josuebouchard/safe-dip-report/images/chapter-3/troubleshooting/damaged-leadscrew-holder/holder-repair-l-brackets.png

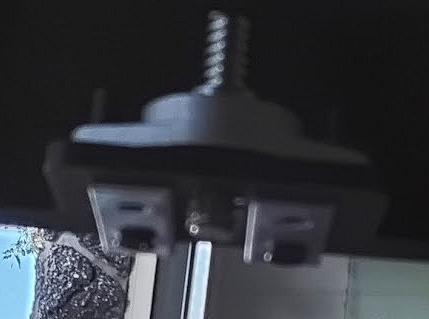
images/chapter-3/troubleshooting/damaged-leadscrew-holder/holder-repair-l-brackets.png
