josuebouchard/safe-dip-report/images/chapter-3/final-design/prototype-running-frame.png

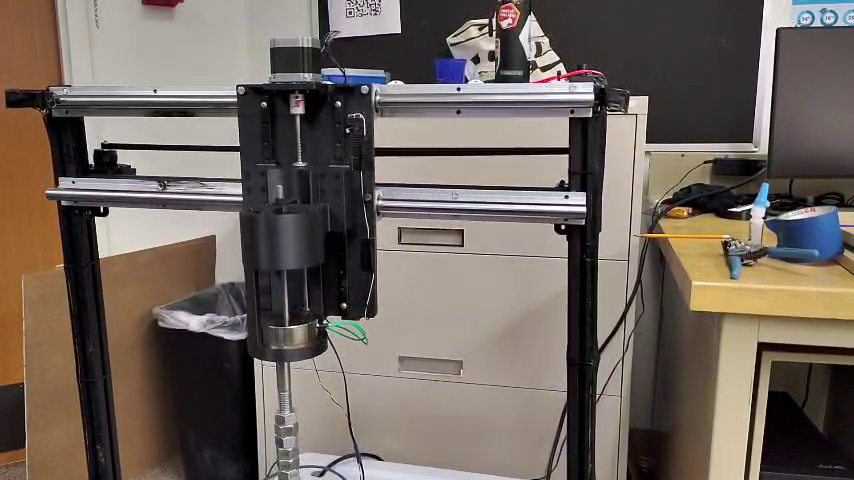
images/chapter-3/final-design/prototype-running-frame.png
