josuebouchard/safe-dip-report/images/chapter-3/implementation/communications-and-monitoring/dashboard-bottom.png

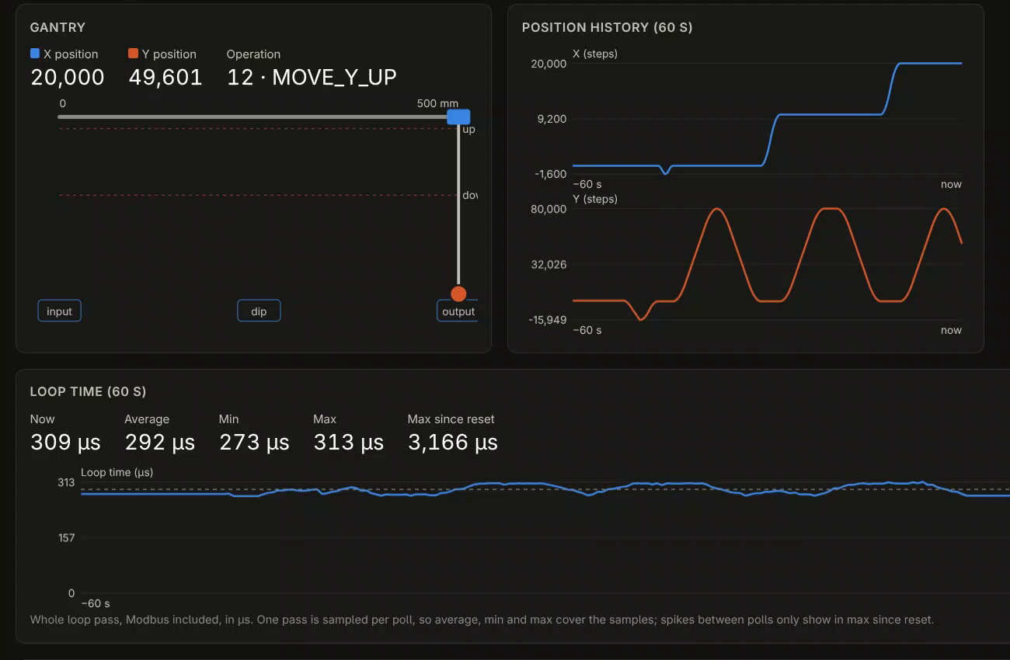
images/chapter-3/implementation/communications-and-monitoring/dashboard-bottom.png
