josuebouchard/safe-dip-report/images/chapter-3/implementation/communications-and-monitoring/dashboard-estop-latched.png

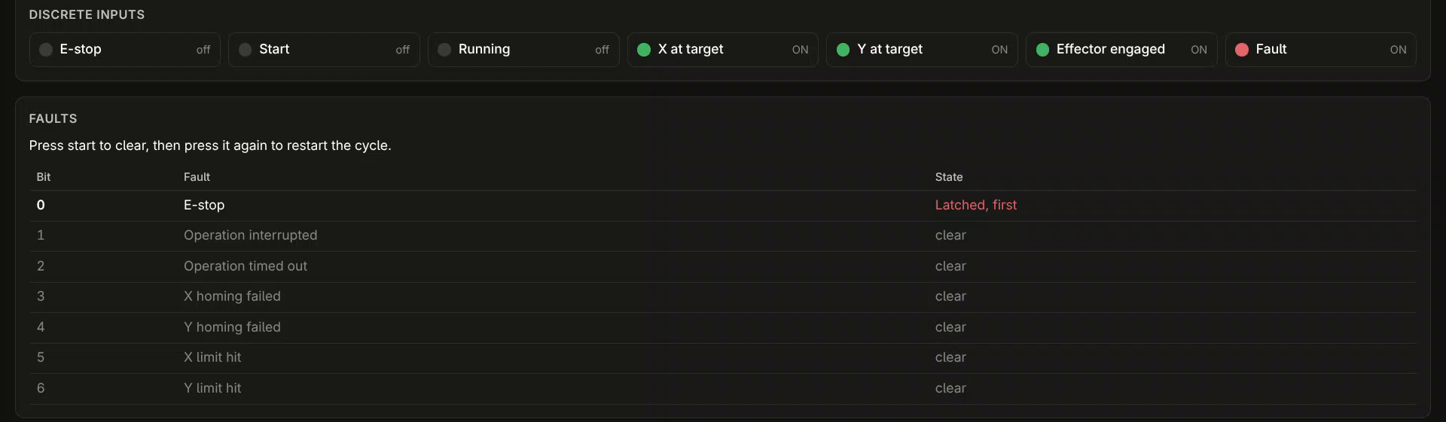
images/chapter-3/implementation/communications-and-monitoring/dashboard-estop-latched.png
