josuebouchard/safe-dip-report/images/chapter-3/implementation/communications-and-monitoring/dashboard-top.png

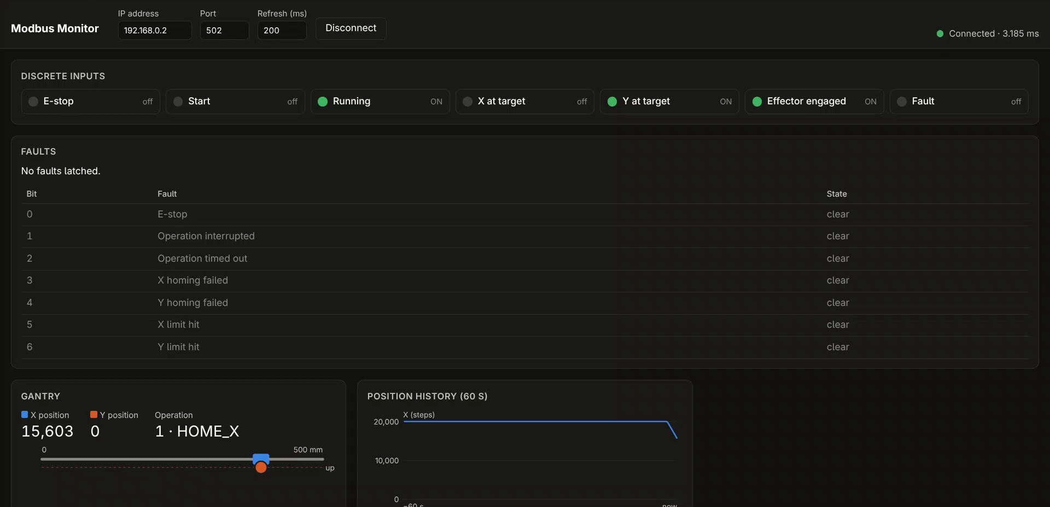
images/chapter-3/implementation/communications-and-monitoring/dashboard-top.png
