josuebouchard/safe-dip-report/images/chapter-3/implementation/sensing/limit-switches-in-video.png

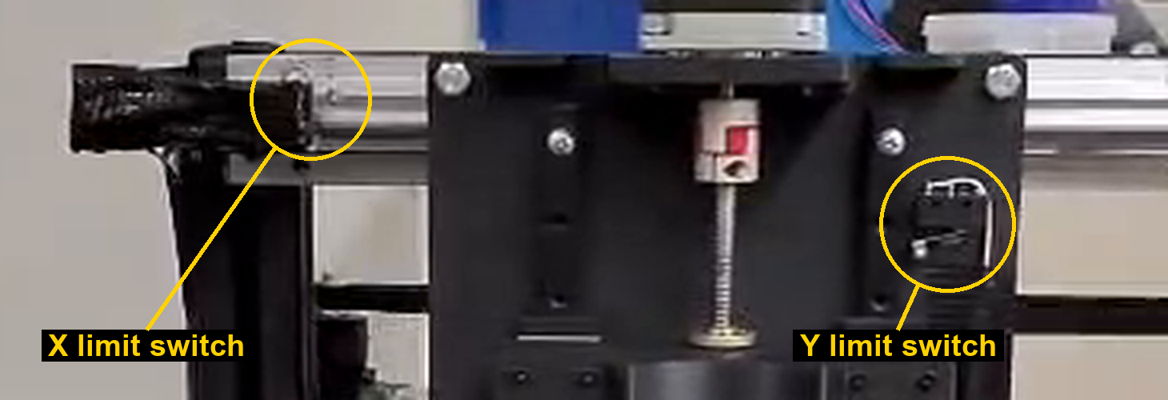
images/chapter-3/implementation/sensing/limit-switches-in-video.png
