josuebouchard/safe-dip-report/images/hardware/limit_switches.jpg

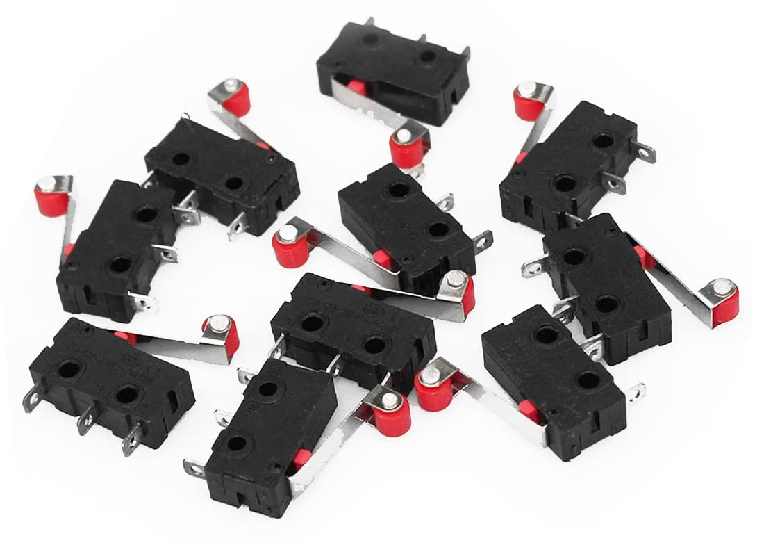
images/hardware/limit_switches.jpg
