josuebouchard/safe-dip-report/images/hardware/meanwell.webp

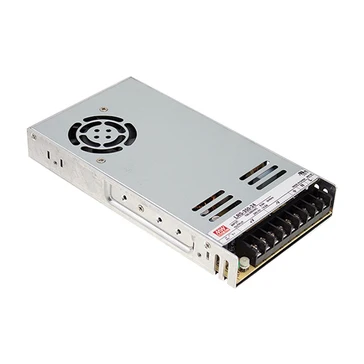
images/hardware/meanwell.webp
