josuebouchard/safe-dip-report/artifacts/EET4950_Weekly_Task_Plan_Safe_Dip.ods

EET 4950 – Weekly Task Plan · Safe Dip · Josué Bouchard, Adriano Mena Duque de Estrada · Fall 2026
Every Sunday, set Status (Done, Partial or Slipped) and fill Actual work and notes for the past week. Move slipped tasks to a later week and note it; do not delete the original row.
Owner = who leads the task; With = who helps. Both = a joint event.
Week | Week starting | Milestone | Task | Owner | With | Status | Actual work and notes
6 | Sep 28, 2026 |  | Rewrite report software section + 4 flowcharts | Josué |  | Done | Section and flowcharts match the firmware
6 | Sep 28, 2026 |  | Modbus map of cycle status and parameters | Josué |  | Partial | On a branch; not yet tested on the board
6 | Sep 28, 2026 |  | Fault reporting: latched e-stop, op. state | Josué |  | Partial | On a branch; bench test moved to Week 7
6 | Sep 28, 2026 |  | Limit-switch inputs and homing operation | Josué |  | Partial | On a branch; switches not yet mounted
6 | Sep 28, 2026 |  | Document power rails and open-drain wiring | Josué |  | Partial | In wiring.md; E5V supply
6 | Sep 28, 2026 |  | Website: flowcharts, nav fix, Week 5 log | Josué |  | Done | Posted on the team website
6 | Sep 28, 2026 |  | CAD: bearing block to plate connections | Adriano |  | Done
7 | Oct 5, 2026 |  | Fabricate mounting plate and 3D-printed carriage parts; mount bearing blocks on rails | Adriano |  | Done
7 | Oct 5, 2026 | Checkpoint 1 – Design Freeze due Sun Oct 11 | Freeze the X-carriage and Y-axis leadscrew CAD; release part drawings and cut list | Adriano |  | Partial | Major design for the X-carriage is done. Some tweaks are still needed to support the Y-axis leadscrew
7 | Oct 5, 2026 |  | Update block diagrams: 24 V supply, open-drain outputs (no buffer), limit switches, E5V | Josué |  | Slipped | Will be done next week
7 | Oct 5, 2026 |  | Draw KiCad schematic sheets for power, processing, movement, effector, e-stop and sensing | Josué |  | Partial | Still missing the part-detection sensor
7 | Oct 5, 2026 |  | Test Modbus registers on the board with madbus-cli | Josué |  | Done | Succesful test
7 | Oct 5, 2026 |  | Bench-test electromagnet driver: IRLZ44N at 3.3 V gate, flyback diode, coil current | Josué | Adriano | Partial | We found that the electromagnet takes about 1.5A of current at 12V DC. Only the magnet was tested; the MOSFET driver circuit moves to Week 9.
7 | Oct 5, 2026 |  | Write and submit Checkpoint 1 (Design Freeze) report | Josué | Adriano | Partial | A first version that better reassembles the structure provided by Dr. Socarras was created. However, things like budget, CAD modeling, and hardware are still to be updated.
7 | Oct 5, 2026 |  | Add the Weekly Task Plan to the website under the Project Timeline | Josué |  | Done | The weekly task plan was added under the project timeline
8 | Oct 12, 2026 |  | Install X-axis motor mount and GT2 belt drive on the frame | Adriano |  | Done | A support for the X-axis motor was successfully installed, as well as parts for coupling the stepper to the belt, holding the ball bearing that will serve as the other foci of the belt, and the contact point between the vertical assembly and the belt.
8 | Oct 12, 2026 |  | Mount X-axis limit switch; wire X driver, motor and switch to the Nucleo | Josué |  | Partial | Switches were defered to another week, since the primary focus will become the correct implementation of the movements before we add the limit switches and the position sensor.
8 | Oct 12, 2026 |  | Calibrate X-axis steps/mm; test homing and ±1 cm positioning (R-02) | Adriano | Josué | Partial | The operation "Homing" has not been tested since the limit switches have not been installed yet. However, the full process was tested with minimum steps skipped, easily attributable to small factors like bad crimping of belt (used clips to temporarily test it) and non-elliptical belt (requires to extrude the connecting part of the vertical assembly to get that).
8 | Oct 12, 2026 |  | Test Modbus communication in real-time with system working | Josué |  | Done | The system behaves correctly, but some disconnections were noticed. The reasons are still yet to be investigated further.
9 | Oct 19, 2026 | Checkpoint 2 – Mid-Build and Viability due Sun Oct 25 | Finish the Y-axis CAD tweaks; install the Y-axis leadscrew assembly, coupler and magnet holder | Adriano |  | Done
9 | Oct 19, 2026 |  | Wire the Y driver and motor to the Nucleo | Josué |  | Done | As it could be seen in previous videos, the stepper motor was succesfully integrated with the rest of the system
9 | Oct 19, 2026 |  | Build and bench-test the IRLZ44N magnet driver from PB10: drain-source voltage at 1.5 A, temperature, engage/release from firmware | Josué |  | Done | The IRLZ44N was substituted with a 5V relay module, providing better safety features than the MOSFET
9 | Oct 19, 2026 |  | Wire and test the 12 V supply: electromagnet rail and 12 V to 5 V buck converter | Josué |  | Partial | The electromagnet rail was successfully validated, but it couldn't be tested with the magnet, though it was tested with the multimeter. The 12V -> 5V buck converter was successfully connected, and voltage correctly adjusted.
9 | Oct 19, 2026 |  | Calibrate Y-axis steps/mm (2 mm lead: 800 steps/mm); test immersion depth ±1 cm (R-04) | Adriano | Josué | Slipped | We were unable to meet this week, so this will be displaced to next week.
9 | Oct 19, 2026 |  | Repeat the Y-axis down/up move 10 times; measure the drift at the top position | Adriano | Josué | Slipped | We were unable to meet this week, so this will be displaced to next week.
9 | Oct 19, 2026 |  | Replace the X-axis belt clips with a permanent belt clamp | Adriano |  | Partial | Waiting for another steeper
9 | Oct 19, 2026 |  | Decide and order the workpiece-detection sensor (time-of-flight, ultrasonic, or IR presence) | Josué | Adriano | Done | Based on the recommendations from the professor, an ultrasonic sensor was chosen because of affordability, abundance, simplicity and power, and, majorly, disponibility
9 | Oct 19, 2026 |  | Run first two-axis cycle without a part from the manual start position: pick, dip, deposit, release | Josué | Adriano | Slipped | The mechanical assembly and the electrical side were tested separately; the full cycle moves to Week 10.
9 | Oct 19, 2026 |  | Record viability video; write and post the Checkpoint 2 report, including the Checkpoint 1 leftovers (budget, CAD, hardware) | Josué | Adriano | Done | The viability video is posted on the Final Testing and Results page, which also lists the requirements still to be tested. An extension to Wed Oct 28, 11:59 PM was granted for the video. The Checkpoint 2 report is posted on the website.
9 | Oct 19, 2026 |  | Website: progress log, time and effort, and advisor-meeting minutes for the week | Josué |  | Done
10 | Oct 26, 2026 | W deadline Fri Oct 30 | Wire NC e-stop into the 24 V driver supply and to the e-stop input (before any test with a part) | Adriano |  | Done | E-stop succesfully interrupts motor power and advises MCU
10 | Oct 26, 2026 |  | Restore the e-stop input in firmware (replaces the reset-button stop) | Josué |  | Done | Software successfully listens for the E-stop advise, halts the sequencer, and resets it on E-stop reset
10 | Oct 26, 2026 |  | Mount the X and Y limit switches on the frame (moved from Weeks 8 and 9) | Adriano |  | Slipped | Moved to Week 11.
10 | Oct 26, 2026 |  | Wire the X and Y limit switches to the Nucleo; test homing (moved from Weeks 8 and 9) | Josué |  | Slipped | Moved to Week 11.
10 | Oct 26, 2026 |  | Verify e-stop cuts driver power and restart needs a start press (R-07, R-08) | Adriano | Josué | Done | Was tested, but not documented formally. Will be done next week after the limit switches installation. The motor-supply relay has since failed with its contact closed. It will be replaced in Week 13 and the test repeated then.
10 | Oct 26, 2026 |  | Calibrate Y-axis steps/mm (2 mm lead: 800 steps/mm); test immersion depth ±1 cm (R-04) | Adriano | Josué | Slipped | Moved from Week 9; moved to Week 11.
10 | Oct 26, 2026 |  | Repeat the Y-axis down/up move 10 times; measure the drift at the top position | Adriano | Josué | Slipped | Moved from Week 9; moved to Week 11.
10 | Oct 26, 2026 |  | Run cycles with a part: retention and dwell time ±1 s (R-03, R-05) | Adriano | Josué | Done | Was tested, but not documented formally. Will be done next week after.
10 | Oct 26, 2026 |  | Run first two-axis cycle without a part from the manual start position: pick, dip, deposit, release | Josué | Adriano | Done | Moved from Week 9. We were finally able to test the full cycle.
10 | Oct 26, 2026 |  | Record and edit the formal viability video with the requirement verifications (due Wed Oct 28, 11:59 PM, extension granted) | Adriano | Josué | Done | The final viability video is posted on the Final Testing and Results page, which lists the requirements still to be tested.
10 | Oct 26, 2026 |  | Project Expenses: proposed budget, total expenses to date, and cost of the final design (three tables, report and website) | Adriano |  | Done
10 | Oct 26, 2026 |  | Investigate the Modbus disconnections seen during operation (moved from Week 11) | Josué |  | Done | The cause was the TCP keep-alive on the Modbus socket. It was removed on 10/27.
10 | Oct 26, 2026 |  | Website: progress log, time and effort, and advisor-meeting minutes for the week | Josué |  | Done
11 | Nov 2, 2026 |  | Mount the X and Y limit switches on the frame (moved from Weeks 8 to 10) | Adriano |  | Slipped | Moved to Week 12.
11 | Nov 2, 2026 |  | Wire the X and Y limit switches to the Nucleo; test homing (moved from Weeks 8 to 10) | Josué |  | Partial | The X switch was wired, but a bug made it always trigger a fault. A fix was written but has not been tested. The Y switch is not wired yet. Moved to Week 12.
11 | Nov 2, 2026 |  | Calibrate Y-axis steps/mm (2 mm lead: 800 steps/mm); test immersion depth ±1 cm (R-04) | Adriano | Josué | Slipped | Calibration is to be done before the tests, and needed the mm-to-steps conversion. The conversion was added and tested, but there was no time left for calibration. Moved to Week 12.
11 | Nov 2, 2026 |  | Repeat the Y-axis down/up move 10 times; measure the drift at the top position | Adriano | Josué | Slipped | Moved to Week 12.
11 | Nov 2, 2026 |  | Run full unattended cycle started by the part-ready trigger (R-01, R-06) | Josué | Adriano | Done | It was triggered using the restart button, but switching it to a special trigger is trivial
11 | Nov 2, 2026 |  | Add limit-switch boundary fault: stop and latch if a switch trips away from 0 | Josué |  | Done | Fault added: a limit-switch press during a move, in either direction, stops the machine and latches the fault. X only for now, since the Y switch is not wired. Not yet merged into the main firmware branch.
11 | Nov 2, 2026 |  | Verify state and faults are reported over Modbus during a cycle (R-09) | Josué |  | Done | Performed informally, video proof will be done next week
11 | Nov 2, 2026 |  | Set the Modbus travel limits to the reduced travel used in the cycle | Josué |  | Slipped | Prior conversion from mm to steps was required for this. It was added (not yet merged into the main firmware branch), but there was no time left for proof
11 | Nov 2, 2026 |  | Tune speed and acceleration for cycle time | Josué |  | Slipped | It was left for next week with all the formal testing
11 | Nov 2, 2026 |  | Start report draft: as-built hardware and software chapters | Josué | Adriano | Partial | Software part has been updated. Hardware part is waiting for final models.
11 | Nov 2, 2026 |  | Install fuse holder; tidy and label wiring | Adriano |  | Slipped
11 | Nov 2, 2026 |  | Website: progress log, time and effort, and advisor-meeting minutes for the week | Josué |  | Done
12 | Nov 9, 2026 | Report draft due Fri Nov 13 | Mount the X and Y limit switches on the frame (moved from Weeks 8 to 11) | Adriano |  | Done | The switches are mounted: glued in place, and the X switch is also taped.
12 | Nov 9, 2026 |  | Wire the X and Y limit switches to the Nucleo; test homing (moved from Weeks 8 to 11) | Josué |  | Done | Both switches are wired. They were very noisy at first and caused false faults; a 3 ms software debounce and braided wires fixed it. Both axes home.
12 | Nov 9, 2026 |  | Calibrate Y-axis steps/mm (2 mm lead: 800 steps/mm); test immersion depth ±1 cm (R-04) | Adriano | Josué | Partial | Both axes are calibrated (X 40 steps/mm, Y 800 steps/mm). The immersion depth is still to be measured.
12 | Nov 9, 2026 |  | Repeat the Y-axis down/up move 10 times; measure the drift at the top position | Adriano | Josué |  | Moved from Weeks 9 to 11.
12 | Nov 9, 2026 |  | Set the Modbus travel limits to the reduced travel used in the cycle (moved from Week 11) | Josué |  |  | Moved from Week 11.
12 | Nov 9, 2026 |  | Tune speed and acceleration for cycle time (moved from Week 11) | Josué |  |  | Moved from Week 11.
12 | Nov 9, 2026 |  | Install fuse holder; tidy and label wiring (moved from Week 11) | Adriano |  |  | Moved from Week 11.
12 | Nov 9, 2026 |  | Run 10 consecutive cycles; record cycle time, depth and dwell (R-10) | Josué | Adriano
12 | Nov 9, 2026 |  | Run full cycle with a 1 lb payload (R-11) | Adriano | Josué
12 | Nov 9, 2026 |  | Write test results chapter; publish Final Testing & Results page | Josué
12 | Nov 9, 2026 |  | Complete and submit report draft (Fri Nov 13) | Josué | Adriano
12 | Nov 9, 2026 |  | Website: progress log, time and effort, and advisor-meeting minutes for the week | Josué
13 | Nov 16, 2026 | Final report due Fri Nov 20 | Build the part-ready trigger input and test R-01 (trigger closed, open, and disconnected) | Adriano | Josué
13 | Nov 16, 2026 |  | Record the quick tests: R-02 drift, R-04 immersion depth, R-05 dwell and R-10 ten consecutive cycles | Josué | Adriano
13 | Nov 16, 2026 |  | Replace the failed motor-supply relay; test and record R-07 and R-08 | Josué | Adriano |  | The relay failed with its contact closed.
13 | Nov 16, 2026 |  | Dimensioned CAD drawings of the as-built assembly | Adriano
13 | Nov 16, 2026 |  | Fix issues found in testing; retest any failed requirement | Josué | Adriano
13 | Nov 16, 2026 |  | Update budget and power budget with as-built parts and measured currents | Adriano
13 | Nov 16, 2026 |  | Address draft feedback; submit final report (Fri Nov 20) | Josué | Adriano
13 | Nov 16, 2026 |  | Website: progress log, time and effort, and advisor-meeting minutes for the week | Josué
14 | Nov 23, 2026 | Thanksgiving week | Draft presentation slides | Adriano | Josué
14 | Nov 23, 2026 |  | Update the material type for each piece | Adriano
14 | Nov 23, 2026 |  | Assemble all the pices into a single CAD | Adriano
14 | Nov 23, 2026 |  | Record final demo video | Josué | Adriano
14 | Nov 23, 2026 |  | Website: final timeline, final report and test results pages | Josué
14 | Nov 23, 2026 |  | Website: progress log, time and effort, and advisor-meeting minutes for the week | Josué
15 | Nov 30, 2026 | Presentation Fri Dec 4 | Rehearse presentation; prepare demo setup and transport checklist | Adriano | Josué
15 | Nov 30, 2026 |  | Present the project (Fri Dec 4) | Both
15 | Nov 30, 2026 |  | Upload final presentation and report to the website | Josué
15 | Nov 30, 2026 |  | Website: progress log, time and effort, and advisor-meeting minutes for the week | Josué
