josuebouchard/safe-dip-report/artifacts/budget.xlsx

Generic Name | Component | Possible provider | Units in Pack | Packs used | Pack price | Amount used | Price per Unit | Price total | Use | In final design
Power Supply (24V) | Mean Well LRS-350-24 | Amazon (Mean Well) (https://www.amazon.com/MEAN-WELL-LRS-350-24-350-4W-Switchable/dp/B013ETVO12) | N/A | N/A | N/A | 1 | $31.47 | $31.47 | Main 48V DC power supply for motors/magnet | Yes
Microcontroler | STM32 NUCLEO-F446RE | Amazon (STMicroelectronics) (https://www.amazon.com/STMicroelectronics-NUCLEO-F446RE-STM32F446RET6-STM32F4-Supports/dp/B07PYY4R5F) | N/A | N/A | N/A | 1 | $31.00 | $31.00 | Main microcontroller/brain of system | Yes
Stepper Motor | 23HS22-2804S Nema 23 | StepperOnline (https://www.omc-stepperonline.com/nema-23-bipolar-1-8deg-1-26nm-178-4oz-in-2-8a-2-5v-57x57x56mm-4-wires-23hs22-2804s) | N/A | N/A | N/A | 2 | $13.37 | $26.74 | Drive the linear dip axis motion Memory | Yes
Stepper Controler | DM542TE Stepper Controller | Amazon (StepperOnline) (https://www.amazon.com/STEPPERONLINE-Digital-Stepper-1-0-4-2A-24-50VDC/dp/B0FYDCRX28) | N/A | N/A | N/A | 2 | $21.00 | $42.00 | Drive/control the Nema 23 steppers | Yes
Ethernet Module | W5500 Ethernet LAN Network Module Support | Amazon (https://www.amazon.com/HiLetgo-Ethernet-Network-Support-Microcontroller/dp/B0CDWX9VQ5) | 2 | 1 | $12.99 | 1 | $6.50 | $6.50 | Ethernet connection enabling telemetry | Yes
E-Stop | 1NC 1NO Red Mushroom Emergency Stop | Amazon (https://www.amazon.com/mxuteuk-Mushroom-Emergency-Warranty-HB2-ES544/dp/B07RJMXDJS) | N/A | N/A | N/A | 1 | $9.99 | $9.99 | Emergency stop, triggers safe mode + power-off | Yes
Power Supply (12V) | ALITOVE Power Supply Adapter Converter Transformer | Amazon (https://www.amazon.com/ALITOVE-Adapter-Converter-100-240V-5-5x2-1mm/dp/B01GEA8PQA) | N/A | N/A | N/A | 1 | $14.00 | $14.00 | Steps down AC to DC for a sub-system rail | Yes
Buck Converter | LM2596 DC a DC Buck | Amazon (https://www.amazon.com/Valefod-Voltage-Regulator-1-5-35V-Converter/dp/B07WQJ2GD6) | 3 | 1 | $13.99 | 1 | $4.67 | $4.67 | Steps 48V/24V down to lower logic voltage (e.g. 12V/5V) | Yes
Electro Magnet | Electromagnet Solenoid BM-P 80-38 | Baomain (https://baomain.com/products/bm-p-80-38) | N/A | N/A | N/A | 1 | $44.98 | $44.98 | Picks up/holds the metal part for dipping Memory+1 | Yes
Shaft Coupler | Shaft coupler (6.35x8mm) | Amazon (https://www.amazon.com/Zeberoxyz-Aluminium-Diameter20mm-Length25mm-Motor%EF%BC%886-35x8mm%EF%BC%89/dp/B08QVK3MWH) | 2 | 1 | $11.99 | 2 | $6.00 | $11.99 | Connects stepper shaft to lead screw | Yes
Limit Switch | HiLetgo Micro Interruptor de Límite KW12-3 | Amazon (https://www.amazon.com/HiLetgo-KW12-3-Roller-Switch-Normally/dp/B07X142VGC) | 10 | 1 | $5.99 | 2 | $0.60 | $1.20 | Assisting in homing operations | Yes
Rail Guide | MGN12H 300mm Linear Rail Guide | Amazon (https://www.amazon.com/dp/B09ZPHPB5F) | 2 | 1 | $35.99 | 2 | $18.00 | $35.99 | Guides the carriage precisely on the dip axis | Yes
Lead Screw | Tr8x2 Lead Screw (300mm) | Amazon (https://www.amazon.com/400mm%EF%BC%8815-75-Inches%EF%BC%89Tr8x8-Thread-Printer-Machine/dp/B08JLV1NF1) | 2 | 1 | $11.99 | 1 | $11.99 | $11.99 | Converts stepper rotation into linear dip motion | Yes
Bearings | Pillow Block Bearing 4Pcs, 5/16" (8mm) | Amazon (https://www.amazon.com/Sydien-Pillow-Flange-Bearing-Self-Alignment/dp/B07C4Y7P2C) | 4 | 1 | $8.49 | 4 | $2.12 | $8.49 | Support/rotate the lead screw smoothly | Yes
Guide Rails | Linear Rail Slide SBR20-800mm | Amazon (https://www.amazon.com/VEVOR-SBR20-1500mm-Bearings-Automated-Equipment/dp/B0BLSCNLLC) | 2 | 1 | $44.90 | 2 | $22.45 | $44.90 | Main structural rail for larger axis travel | Yes
Belt | 3D Printing GT2 Timing Belt | Amazon (https://www.amazon.com/dp/B01COGMPPU?lv=shuf&channelId=481&plpRedirect=mhFallback) | Kit | N/A | N/A | 1 | $16.88 | $16.88 | Transmits motion for the conveyor X-axis | Yes
Aluminum Beams | 4040 T-Slot Extruded Aluminum Profile 1000mm | Amazon (https://www.amazon.com/T-Slot-Extruded-Aluminum-Profile-400mm/dp/B0DCNZX65D) | 4 | 1 | $79.99 | 4 | $20.00 | $79.99 | Frame/structure for the whole rig | Yes
Flyback Diode | BOJACK 1N4007 Rectifier Diode | Amazon (https://www.amazon.com/dp/B07Q6J9TNW?lv=shuf&channelId=481&plpRedirect=mhFallback) | 125 | 1 | $5.99 | 1 | $0.05 | $0.05 | Protects circuit from magnet coil's back-EMF Memory | Yes
Wires | 100FT 18 Gauge Wire 2 Conductor | Amazon (https://www.amazon.com/dp/B0CXMCKL1Q) | Kit | N/A | N/A | 1 | $12.29 | $12.29 | General wiring | Yes
Heat shrink | Eventronic Heat Shrink Tubing 2:1 | Amazon (https://www.amazon.com/dp/B072PCQ2LW?lv=shuf&channelId=481&plpRedirect=mhFallback) | 560 | 1 | $6.99 | 1 | $6.99 | $6.99 | Insulates/protects wire splices | Yes
Fuse Holder | FEBRYTOLD 0 Gauge Inline Fuse Holder | Amazon (https://www.amazon.com/dp/B08QHM447K?lv=shuf&channelId=481&plpRedirect=mhFallback) | 2 | 1 | $8.49 | 1 | $4.25 | $4.25 | Overcurrent protection on a power rail | Yes
Resistors kit | Upvivi Resistor Assortment Kit | Amazon (https://www.amazon.com/dp/B0D4QFB2WD?lv=shuf&channelId=481&plpRedirect=mhFallback) | Kit | N/A | N/A | 1 | $6.99 | $6.99 | Gate resistors, pull-ups/downs, current limiting | Yes
Bolt and Nuts Kit | Button Head Socket Cap Screws Bolts Nuts Kit M5 | Amazon (https://www.amazon.com/dp/B0BG5WMGH9?lv=shuf&channelId=481&plpRedirect=mhFallback) | Kit | N/A | N/A | 1 | $16.99 | $16.99 | General assembly fastening | Yes
Relays | 10pcs DC 5V Relay Module - 1 Channel | Amazon (https://www.amazon.com/dp/B0BHLDW9G5) | 10 | 1 | $11.99 | 3 | $1.20 | $3.60 | E-stop connections and effector control | Yes
Motor Mounting | Nema 23 Stepper Motor Steel Mounting Bracket | Amazon (https://www.amazon.com/dp/B073V77VLD?lv=shuf&channelId=481&plpRedirect=mhFallback) | 4 | 1 | $11.99 | 4 | $3.00 | $11.99 | Mounts stepper motors to frame | Yes
Wago Connectors | WAGO 221 35pc Assortment | Amazon (https://www.amazon.com/dp/B0BRBPSM9Q) | Kit | N/A | N/A | 1 | $30.00 | $30.00 | Splicing wires | Yes
M3 Screws | M3 40 mm Screws Set | Amazon (https://www.amazon.com/dp/B0FGJ9FRGQ) | Kit | N/A | N/A | 1 | $12.00 | $12.00 | Fasten the 3D-printed parts (8 used) | Yes
M5 Screws | M5 30 mm Screws Set | Amazon (https://www.amazon.com/dp/B0BG5WMGH9) | Kit | N/A | N/A | 1 | $17.00 | $17.00 | Assembly fastening (4 used) | Yes
5/16" Screw | 5/16" Screw, 1 ft | Home Depot | N/A | N/A | N/A | 1 | $6.00 | $6.00 | Secondary retention of the magnet holder | Yes
5/16" Nuts and Washers | 5/16" Nuts and Washers (2 each) | Home Depot | N/A | N/A | N/A | 1 | $5.00 | $5.00 | Secure the 5/16" screw | Yes
Small L-Brackets | Small L Metal Bracket | Home Depot | N/A | N/A | N/A | 2 | $1.50 | $3.00 | Support the bottom part | Yes
L-Brackets | L Metal Bracket | Home Depot | N/A | N/A | N/A | 16 | $1.25 | $20.00 | Fix the frame | Yes
PLA Filament | PLA 3D Printer Filament Spool | Amazon (https://www.amazon.com/dp/B0C14PVBPB) | N/A | N/A | N/A | 4 | $13.49 | $53.96 | 3D-printed parts | Yes
Aluminum Beams (extra) | 4040 T-Slot Extruded Aluminum Profile 1000mm | Amazon (https://www.amazon.com/dp/B0DCNZX65D) | 4 | 1 | $80.00 | 4 | $20.00 | $80.00 | Additional frame structure | Yes
Buzzer | Gikfun Terminals Passive Electronic Buzzer | Amazon (https://www.amazon.com/Gikfun-Terminals-Passive-Electronic-Arduino/dp/B01GJLE5BS) | 10 | 1 | $8.98 | 2 | $0.90 | $1.80 | Audible alert (e.g. cycle done, fault, E-stop) | No
T-nuts | 4040 Series T Sliding Nuts Hammer Nut Block Square | Amazon (https://www.amazon.com/dp/B09J1FDQQJ?lv=shuf&channelId=481&plpRedirect=mhFallback) | 15 | 1 | $9.99 | 15 | $0.67 | $9.99 | Fasten components to 4040 extrusion | No
Nut Block | Lysee 3D Printer Parts & Accessories | Amazon (https://www.amazon.com/dp/B092TLGXB7?lv=shuf&channelId=481&plpRedirect=mhFallback&th=1) | 2 | 1 | $20.19 | 2 | $10.10 | $20.19 | Removes lead screw backlash for repeatable positioning | No
Total (without taxes): | $744.85
Total (without taxes, final): | $712.87
