josuebouchard/safe-dip-report/images/chapter-3/troubleshooting/frame-wobble/frame-l-bracket.jpg

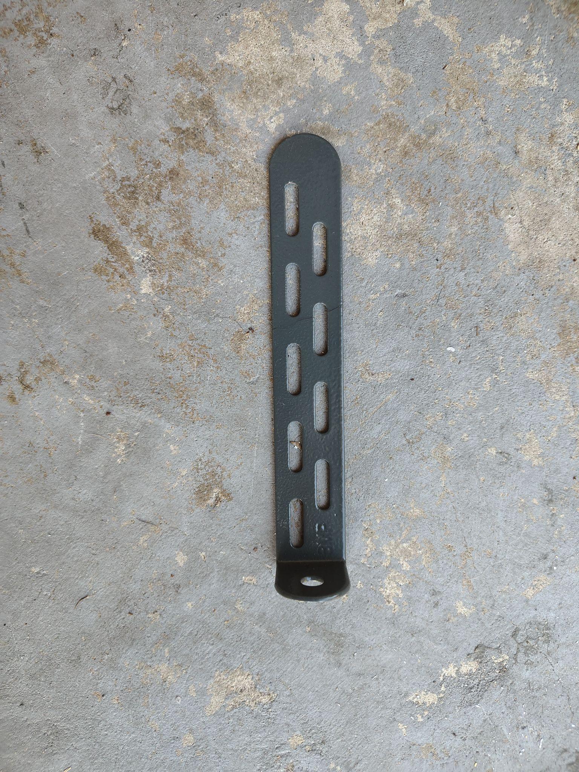
images/chapter-3/troubleshooting/frame-wobble/frame-l-bracket.jpg
