josuebouchard/safe-dip-report/images/chapter-3/design-integration-and-flow-charts/homing.pdf

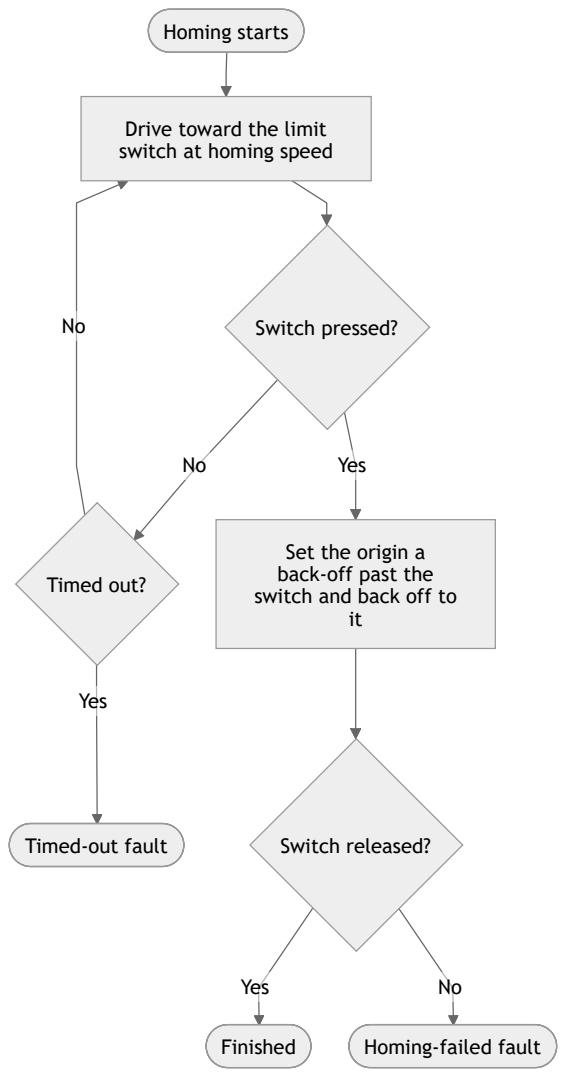
[picture p10: page 1]
Yes; Homing starts; Switch pressed?; Timed out?; Switch released?; Finished; Homing-failed fault

Drive toward the limit
switch at homing speed

Set the origin a
back-off past the
switch and back off to

Timed-out fault
