josuebouchard/safe-dip-report/images/chapter-3/design-integration-and-flow-charts/main-loop.pdf

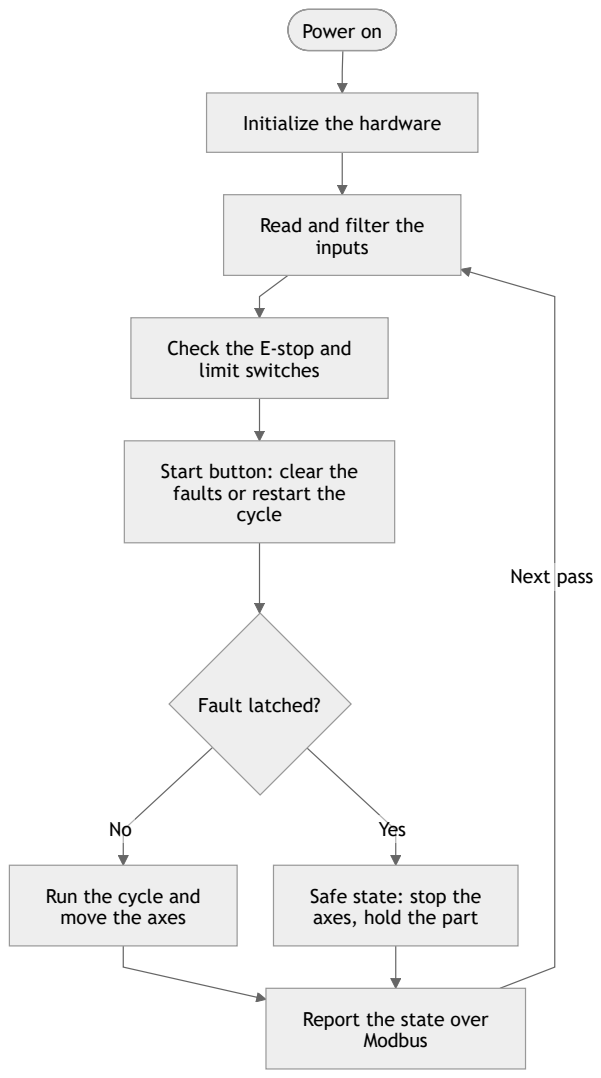
[picture p11: page 1]
Yes; Next pass; Power on; Fault latched?

Initialize the hardware

Read and filter the
inputs

Check the E-stop and
limit switches

Start button: clear the
faults or restart the
cycle

Run the cycle and
move the axes

Safe state: stop the
axes, hold the part

Report the state over
Modbus
