josuebouchard/safe-dip-report/images/chapter-3/design-integration-and-flow-charts/motion-controller.pdf

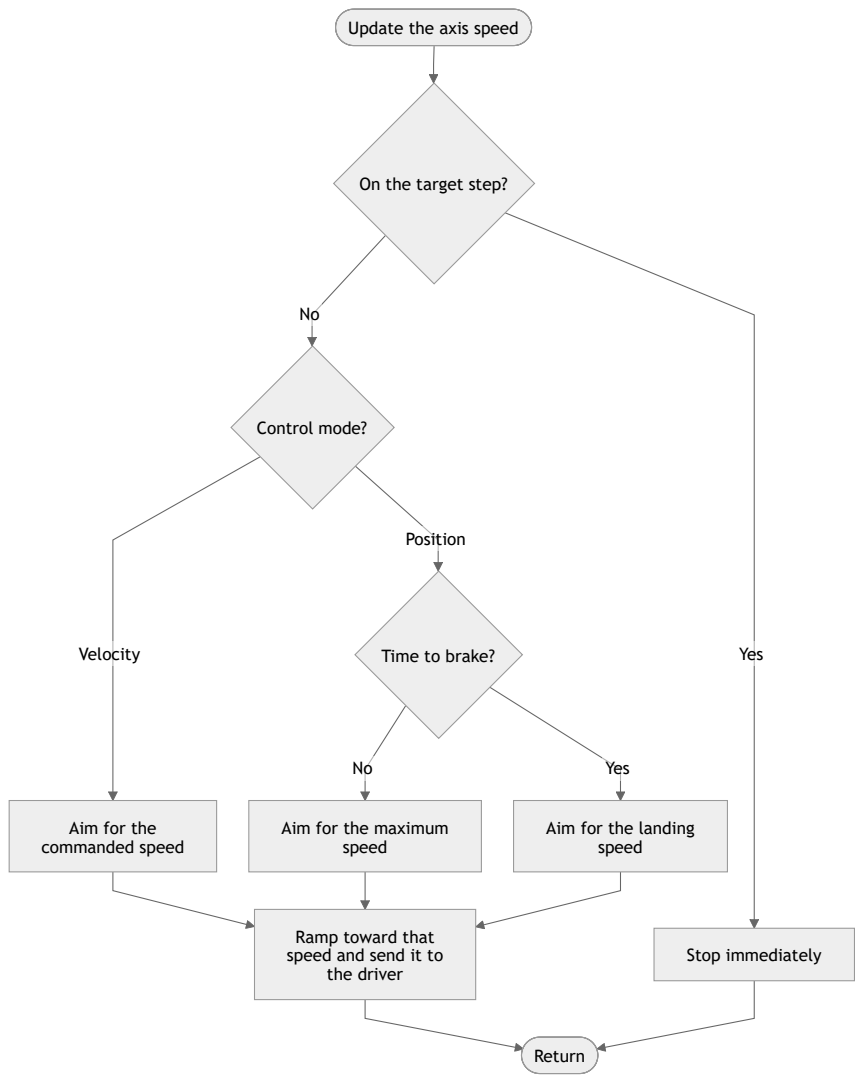
[picture p12: page 1]
Yes; Velocity; Position; Stop immediately; Control mode?; speed; Return

Update the axis speed

On the target step?

Time to brake?

Aim for the
commanded speed

Aim for the maximum

Aim for the landing
speed

Ramp toward that
speed and send it to
the driver
