josuebouchard/safe-dip-report/images/chapter-3/design-integration-and-flow-charts/move-operation.pdf

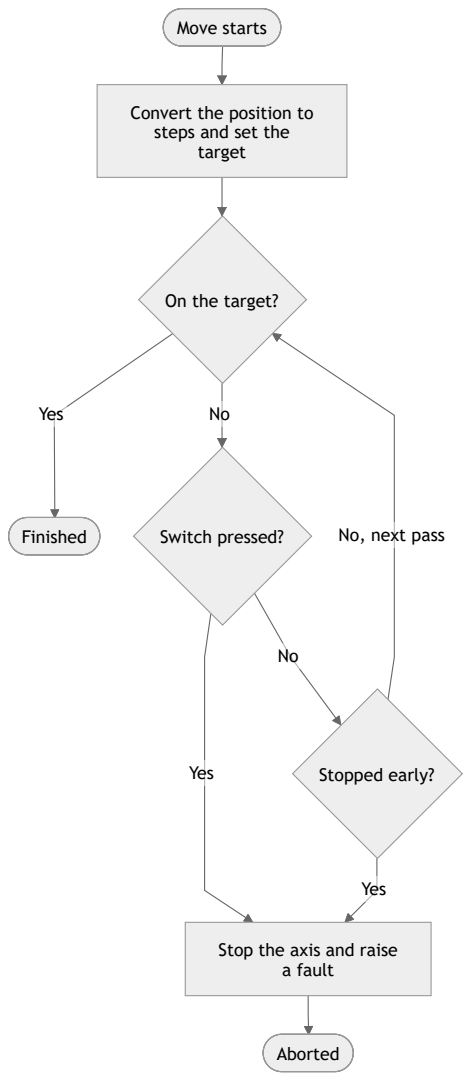
[picture p13: page 1]
Yes; Move starts; Finished; Switch pressed?; a fault; Stopped early?; Aborted

Convert the position to
steps and set the
target

On the target?

No, next pass

Stop the axis and raise
