josuebouchard/safe-dip-report/images/chapter-3/design-integration-and-flow-charts/normal-cycle.pdf

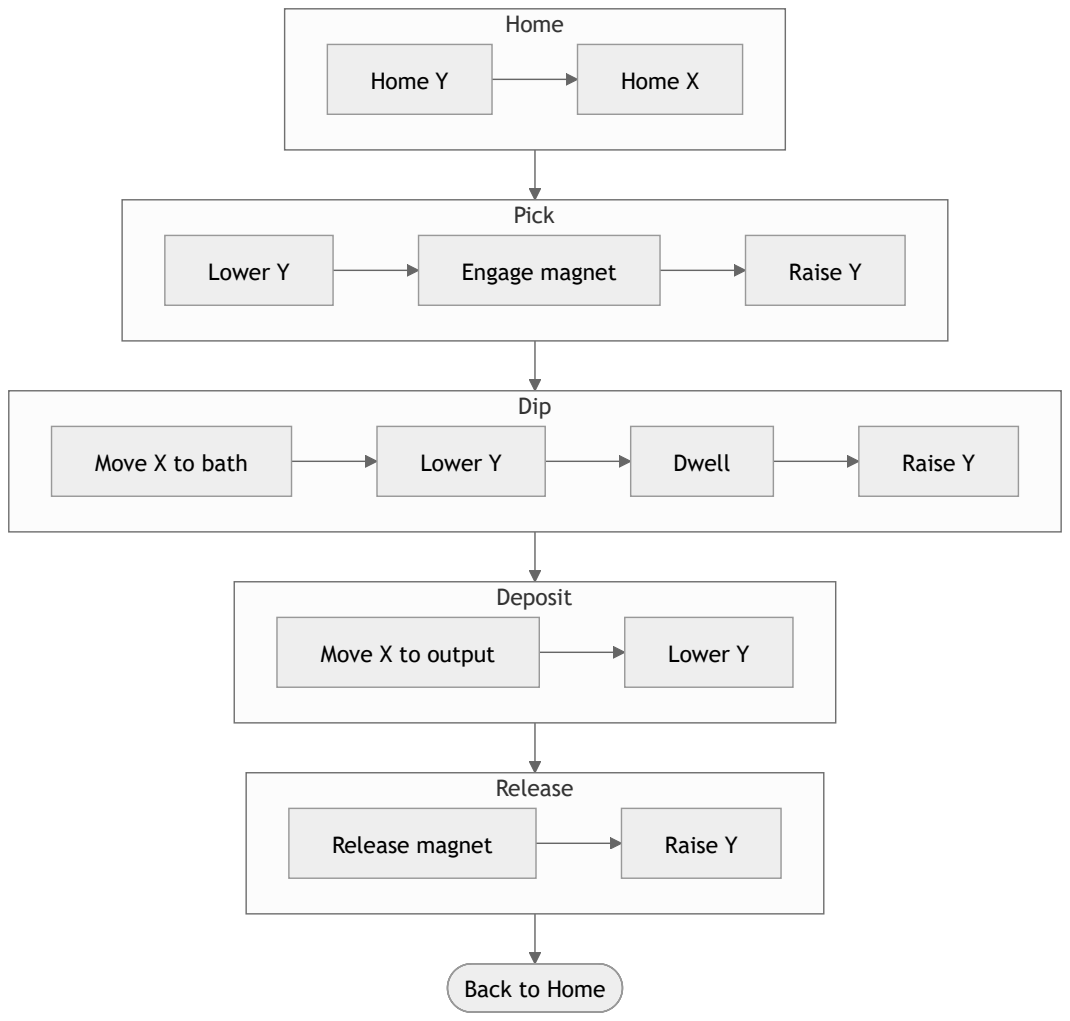
[picture p14: page 1]
Release; Release magnet; Raise Y; Deposit; Move X to output; Lower Y; Dip; Move X to bath; Dwell; Pick; Engage magnet; Home; Home Y; Home X

Back to Home
