josuebouchard/safe-dip-report/images/chapter-3/design-integration-and-flow-charts/sequencer.pdf

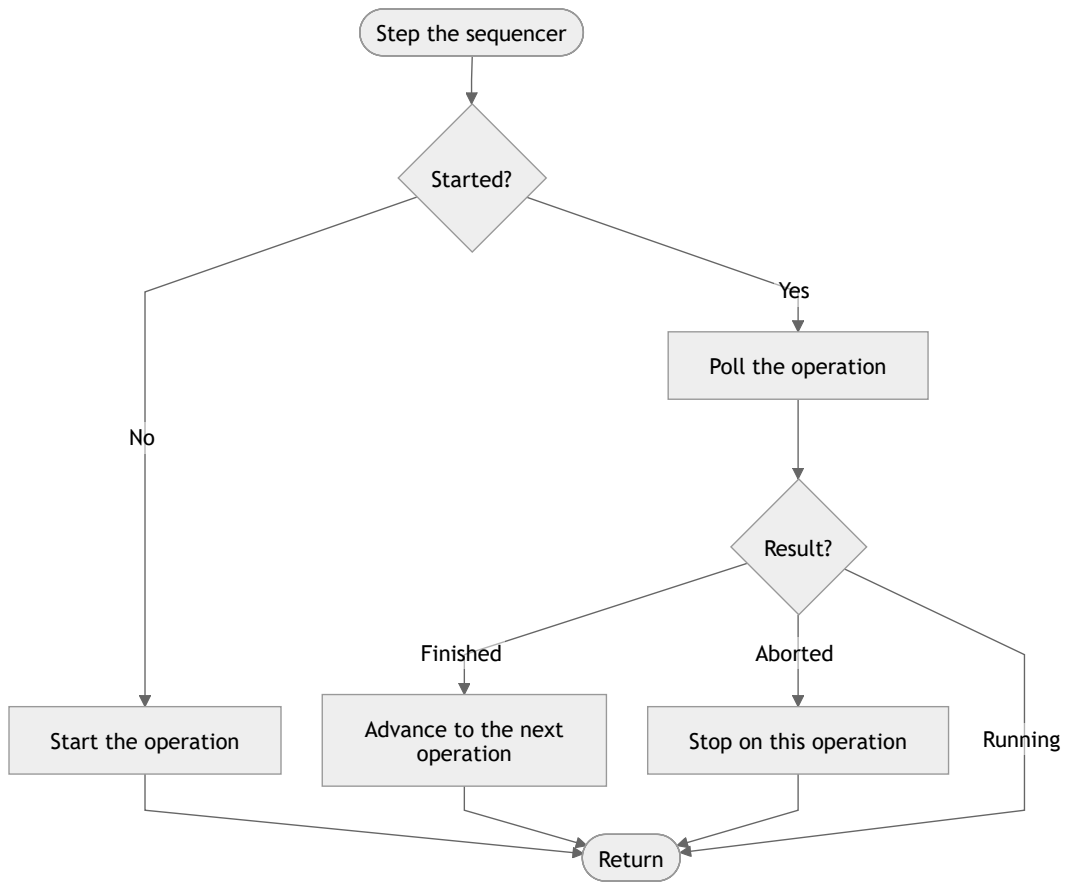
[picture p15: page 1]
Yes; Finished; Aborted; Running; Started?; Result?; Return

Step the sequencer

Poll the operation

Advance to the next
operation

Start the operation

Stop on this operation
