josuebouchard/safe-dip-report/kicad_schematic/kicad_schematic.kicad_sch

## KiCad design kicad_schematic/kicad_schematic.kicad_sch (2026-11-02)

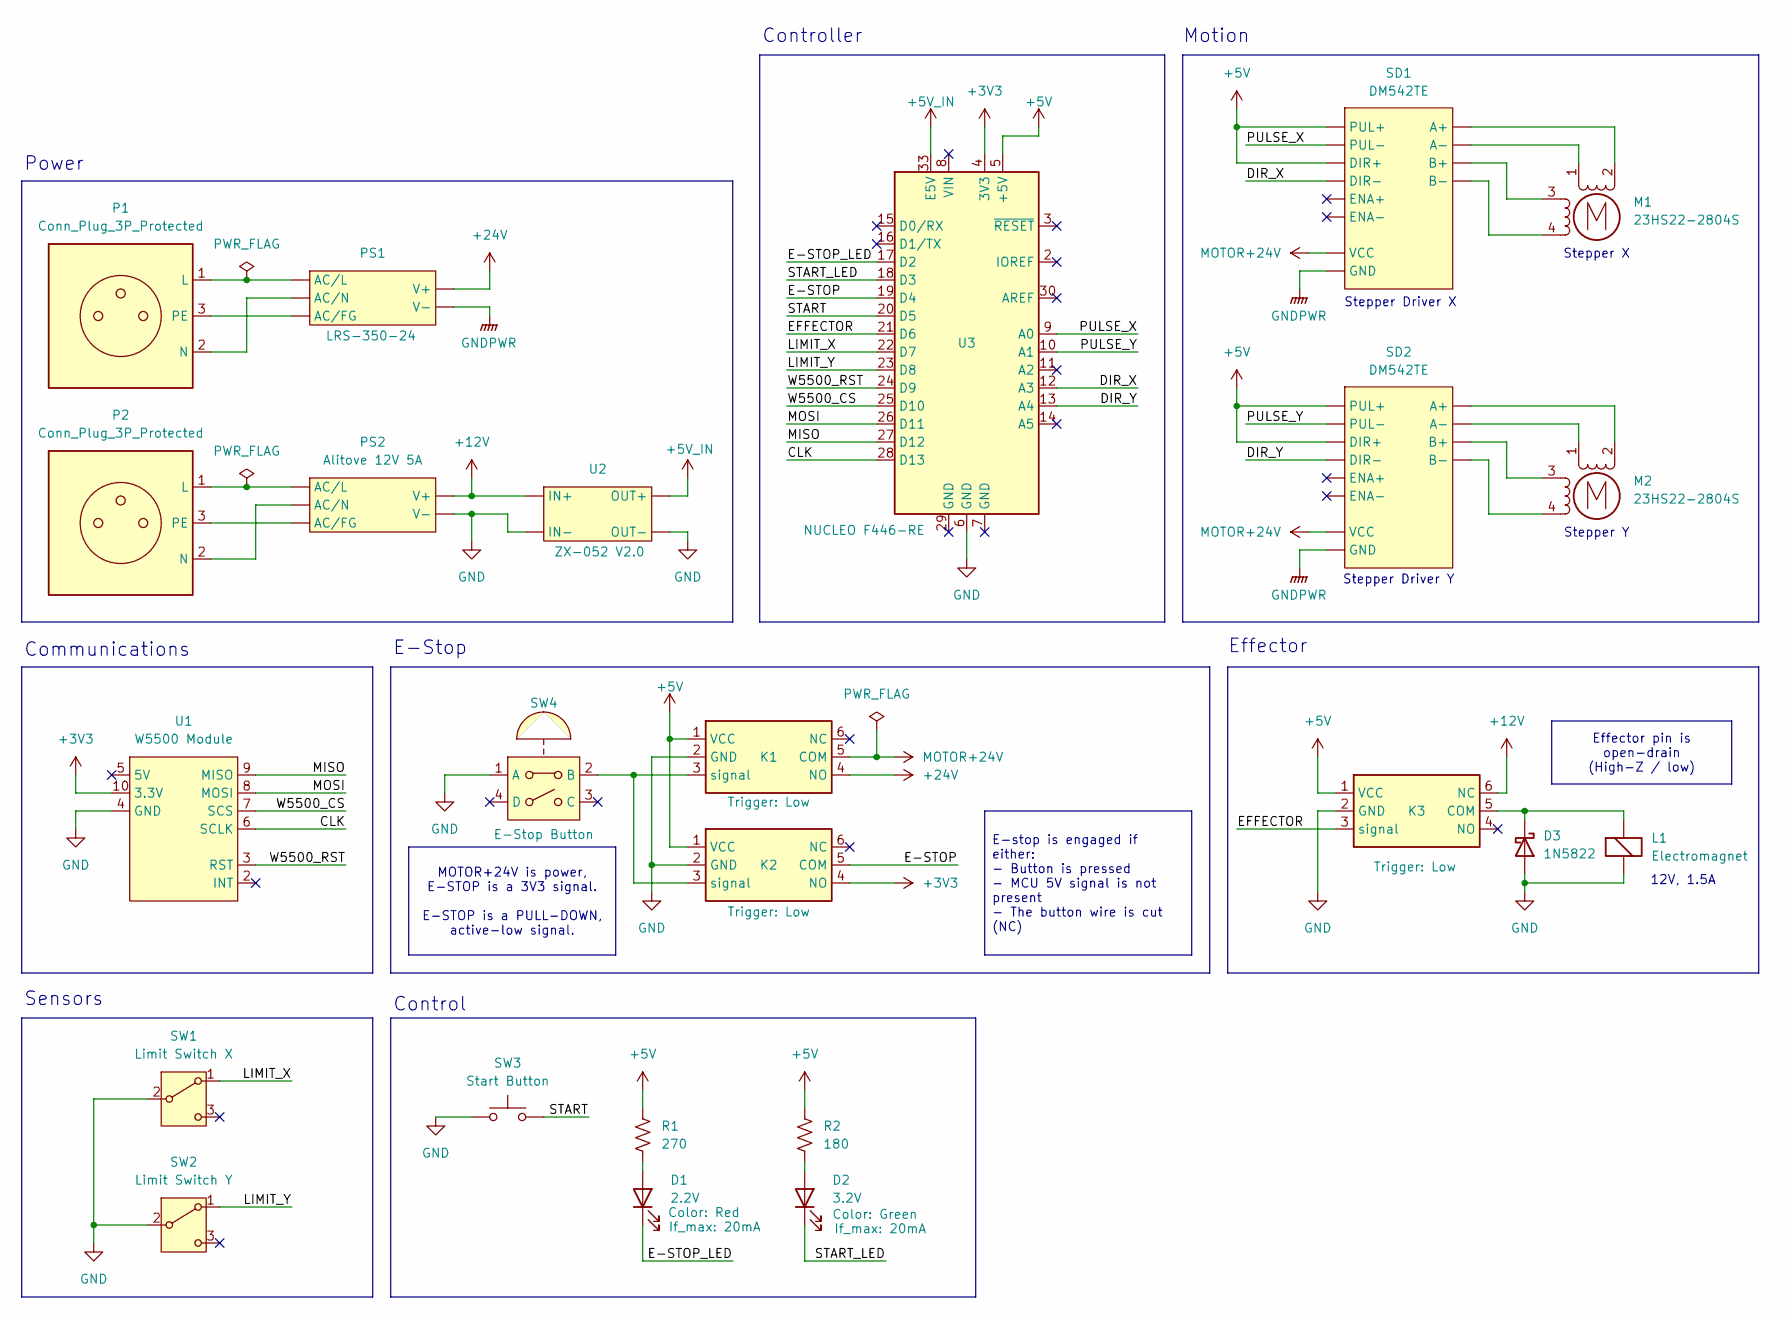
[picture p16: schematic kicad_schematic.kicad_sch]

Parts:
D1: 2.2V
D2: 3.2V
D3: 1N5822; D_DO-201AD_P15.24mm_Horizontal
K1, K2, K3: (no value)
L1: Electromagnet
M1, M2: 23HS22-2804S
P1, P2: Conn_Plug_3P_Protected
PS1: LRS-350-24
PS2: Alitove 12V 5A
R1: 270
R2: 180
SD1, SD2: DM542TE
SW1: Limit Switch X
SW2: Limit Switch Y
SW3: Start Button
SW4: E-Stop Button
U1: W5500 Module
U2: ZX-052 V2.0
U3: NUCLEO F446-RE

Connections:
+3V3: K2.4 (NO), U1.10 (3.3V), U3.4 (3V3)
+5V: K1.1 (VCC), K2.1 (VCC), K3.1 (VCC), R1.1, R2.1, SD1.1 (PUL+), SD1.3 (DIR+), SD2.1 (PUL+), SD2.3 (DIR+), U3.5 (+5V)
+5V_IN: U2.3 (OUT+), U3.33 (E5V)
+12V: K3.6 (NC), PS2.4 (V+), U2.1 (IN+)
+24V: K1.4 (NO), PS1.4 (V+)
CLK: U1.6 (SCLK), U3.28 (D13)
DIR_X: SD1.4 (DIR-), U3.12 (A3)
DIR_Y: SD2.4 (DIR-), U3.13 (A4)
E-STOP: K2.5 (COM), U3.19 (D4)
E-STOP_LED: D1.1 (K), U3.17 (D2)
EFFECTOR: K3.3 (signal), U3.21 (D6)
GND: D3.2 (A), K1.2 (GND), K2.2 (GND), K3.2 (GND), L1.2 (+), PS2.5 (V-), SW1.2 (B), SW2.2 (B), SW3.1, SW4.1 (A), U1.4 (GND), U2.2 (IN-), U3.6 (GND)
GNDPWR: PS1.5 (V-), SD1.8 (GND), SD2.8 (GND)
LIMIT_X: SW1.1 (A), U3.22 (D7)
LIMIT_Y: SW2.1 (A), U3.23 (D8)
MISO: U1.9 (MISO), U3.27 (D12)
MOSI: U1.8 (MOSI), U3.26 (D11)
MOTOR+24V: K1.5 (COM), SD1.7 (VCC), SD2.7 (VCC)
unnamed: D1.2 (A), R1.2
unnamed: D2.2 (A), R2.2
unnamed: D3.1 (K), K3.5 (COM), L1.1 (-)
unnamed: K1.3 (signal), K2.3 (signal), SW4.2 (B)
unnamed: M1.1, SD1.10 (A-)
unnamed: M1.2 (-), SD1.9 (A+)
unnamed: M1.3, SD1.11 (B+)
unnamed: M1.4, SD1.12 (B-)
unnamed: M2.1, SD2.10 (A-)
unnamed: M2.2 (-), SD2.9 (A+)
unnamed: M2.3, SD2.11 (B+)
unnamed: M2.4, SD2.12 (B-)
unnamed: P1.1 (L), PS1.1 (AC/L)
unnamed: P1.2 (N), PS1.2 (AC/N)
unnamed: P1.3 (PE), PS1.3 (AC/FG)
unnamed: P2.1 (L), PS2.1 (AC/L)
unnamed: P2.2 (N), PS2.2 (AC/N)
unnamed: P2.3 (PE), PS2.3 (AC/FG)
PULSE_X: SD1.2 (PUL-), U3.9 (A0)
PULSE_Y: SD2.2 (PUL-), U3.10 (A1)
START: SW3.2, U3.20 (D5)
START_LED: D2.1 (K), U3.18 (D3)
W5500_CS: U1.7 (SCS), U3.25 (D10)
W5500_RST: U1.3 (RST), U3.24 (D9)

Notes on the sheet:
Stepper Driver Y
Power
12V, 1.5A
Stepper Y
Motion
Sensors
Stepper X
Control
Communications
Controller
E-Stop
Effector
Stepper Driver X
Effector pin is open-drain (High-Z / low)
MOTOR+24V is power, E-STOP is a 3V3 signal. E-STOP is a PULL-DOWN, active-low signal.
E-stop is engaged if either: - Button is pressed - MCU 5V signal is not present - The button wire is cut (NC)
