josuebouchard/safe-dip-report/(commit log)

2026-10-26 docs: add the report PDF and the project artifacts
    Report PDF, Weekly Task Plan, budget, KiCad schematic export and modified Gantt chart.
    [EET4950_Weekly_Task_Plan_Safe_Dip.ods, budget.xlsx]
2026-10-26 feat(schematic): add the KiCad schematic source
    [kicad_schematic.kicad_sch]
2026-10-28 feat: sync the Gantt, plan and report PDF with the Oct 27 plan
    E-stop verification moved to Week 11 and a W10 viability video bar added; plan and PDF artifacts refreshed.
    [EET4950_Weekly_Task_Plan_Safe_Dip.ods]
2026-10-28 docs: refresh the Weekly Task Plan artifact
    [EET4950_Weekly_Task_Plan_Safe_Dip.ods]
2026-11-02 feat: sync the report with the Nov 1 Typst export
    Schematic V2, the updated block diagrams, the trigger-based R-01, the
    power-loss limitation, the limit-switch sensing section, and the revised
    power budget and component budget.
2026-11-02 fix: replace the remaining part-sensor and direct-wired e-stop wording
    Describe the part-ready trigger instead of the ultrasonic sensor in the
    abstract, introduction, conclusion, task distribution and hazards table,
    start R-06 from the trigger, describe the e-stop through relays K1 and K2,
    place one limit switch at the home end of each axis, and remove a stray
    backslash from the first budget price.
2026-11-02 fix: drop the remaining ultrasonic-sensor mentions from the task distribution
2026-11-02 fix: correct the stepper model and relay price in the budget
    The stepper is the 23HS22-2804S, and three relays from a 10-pack cost
    $3.60, which brings the total to $547.89.
2026-11-02 feat(schematic): update the KiCad source to rev V2
    Relays K1 and K2 for the e-stop and K3 for the effector, the limit
    switches on D7 and D8, and the status LEDs on D2 and D3.
    [kicad_schematic.kicad_sch]
2026-11-02 fix(schematic): keep only the project's own symbol library
    The schematic takes every custom symbol, the Nucleo included, from
    my_lib, so the separate NUCLEO-F446RE library is unused.
2026-11-02 docs: export the rev V2 schematic PDF
2026-11-02 fix(references): match the datasheet list to the current design
    Drop the HC-SR04, which the design no longer uses, add the LM2596 buck
    converter and 1N4007 diode datasheets, and stop the Mean Well publisher
    from rendering as a person's name.
2026-11-02 ci: build the report, Gantt chart and schematic on every push
    Compiles the report with Typst 0.15.1, exports the modified Gantt chart
    on its own as an SVG for the website, and exports the schematic with
    KiCad 10's kicad-cli, uploading the files as run artifacts kept for 7
    days. Fails if a photo in images/ or the built PDF carries location or
    device metadata. Runs with a read-only token, cancels superseded runs,
    and times out after 15 minutes.
2026-11-02 docs: update the Weekly Task Plan through Week 10
    Records the Week 10 statuses and starts the Week 11 cycle from the
    part-ready trigger instead of part detection.
    [EET4950_Weekly_Task_Plan_Safe_Dip.ods]
2026-11-02 docs: merge the Week 10 plan into the Oct 27 version
    The Week 10 update was made on a copy from before Oct 27, which dropped
    the formal viability video and the Y-axis calibration rows. Restores
    them, marks the slipped Week 10 tasks and moves them to Week 11, and
    records the full two-axis cycle in Week 10.
    [EET4950_Weekly_Task_Plan_Safe_Dip.ods]
2026-11-02 fix(timeline): match the modified Gantt to the Week 10 plan
    The limit switches and the Y-axis calibration move to Week 11, the
    emergency stop finished in Week 10, and the part-detection bar keeps only
    the Week 9 sensor decision.
2026-11-02 ci: upload each file on its own
    The report PDF, the Gantt SVG and the schematic PDF are uploaded unzipped
    as separate artifacts named after the files, and the report PDF is named
    like its copy in artifacts/.
2026-11-02 ci: build the schematic only when it changes
    Downloading the KiCad image takes most of the schematic job's minute, so
    it moves to its own workflow that runs only for changes to the schematic
    or from the Run workflow button. The report workflow skips pushes that
    only change the schematic.
2026-11-02 chore: stop keeping the generated files in artifacts/
    The report PDF, the Gantt SVG and the schematic PDF are built by the
    workflows on every relevant push, so only the files the team edits by hand
    stay in artifacts/: the Task Plan and the budget.
2026-11-02 fix: take the schematic image from the workflow's KiCad 10.0.8 export
2026-11-02 ci: also export the schematic as SVG
    kicad-cli writes the SVG next to the PDF, and it is uploaded the same way.
2026-11-02 fix: use KiCad's own SVG export for the schematic image
    Takes images/hardware/schematic.svg from the Build schematic workflow's
    kicad_schematic.svg instead of converting the PDF.
2026-11-02 fix: wait for the part-ready trigger instead of the ultrasonic sensor
    Updates the planned WAIT_FOR_PART operation in 3.1, now WAIT_FOR_TRIGGER,
    and replaces artifacts/budget.xlsx with the corrected sheet (three relays
    at $1.20, the 23HS22-2804S motor, $547.89).
    [budget.xlsx]
2026-11-03 feat(budget): split Project Expenses into the three required tables
    The proposed budget from the proposal, the total spent to date (whole
    packs, including parts later dropped) and the cost of the final design.
    budget.xlsx gains Adriano's new parts and an In final design column, and
    the dropped nut block, T-nuts and buzzer are marked No.
    [budget.xlsx]
2026-11-03 docs(budget): take the team's sheet with the final-design total
    The dropped parts move to the end of the table, and a second total sums
    only the parts in the final design ($712.87).
    [budget.xlsx]
2026-11-03 docs: add a README describing the repository
    How to build the report, the Gantt chart and the schematic, what the
    automatic builds produce, notes for working on the report, and an
    all-rights-reserved notice.
2026-11-09 Update the Weekly Task Plan for Week 11 and move the Gantt bars
    [EET4950_Weekly_Task_Plan_Safe_Dip.ods]
2026-11-11 docs: add the formulas linking stepper pulses and millimeters
    Derive pulses per revolution, travel per revolution, the steps/mm scale
    factor and the conversions both ways, with a per-axis table in 2.1.1.
    Restate the Chapter 3 tuning per axis to match the firmware, name the
    leadscrew Tr8x8 as purchased, and turn the appendix mentions into
    references, which fixes the one that pointed at Appendix A.
2026-11-11 docs: draft Chapter 3 from the logs, firmware and roadblocks
    Write the implementation, troubleshooting, requirement testing,
    verification summary and final design sections, and update the design
    integration section to the firmware on main. Redraw the flowcharts
    that changed and sort the chapter's images into one folder per
    subtitle. Missing test results are marked with to-do boxes.
2026-11-13 docs: redraw the Chapter 3 flowcharts in Mermaid and restyle videos
    Replace the generated SVG flowcharts and the Lucid motion controller chart
    with Mermaid sources (.mmd) built into PDFs by build.sh, so they can be
    edited without scripts. Update the text to the fix/review-findings
    firmware, add a code-review entry to Troubleshooting, restyle video
    entries as left-aligned boxes, list videos in the List of Figures, and
    document the diagram build in the README.
2026-11-14 Update the report for the near-final checkpoint
    Chapter 3 results, wiring and troubleshooting, Appendix A listings,
    firmware-size chart, subfigures, and fixes to the proposal wording.
    [loc.csv]
2026-11-14 Update the Weekly Task Plan for Week 12 and add the Week 13 tasks
    [EET4950_Weekly_Task_Plan_Safe_Dip.ods]
